wyndec/CoCoKeys2USB/(commit log)

2020-05-21 update to v1.21 - added Shift+Enter to switch emulator modes
2020-05-21 added docs folder and documentation file for encoder
